dchoi98/iot-water-valve/images/external_view.jpg

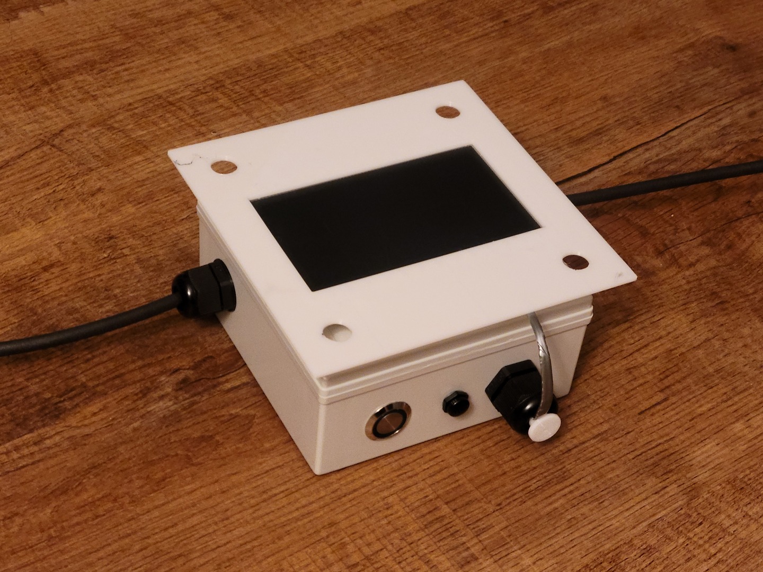
images/external_view.jpg
