dchoi98/iot-water-valve/images/internal_view.jpg

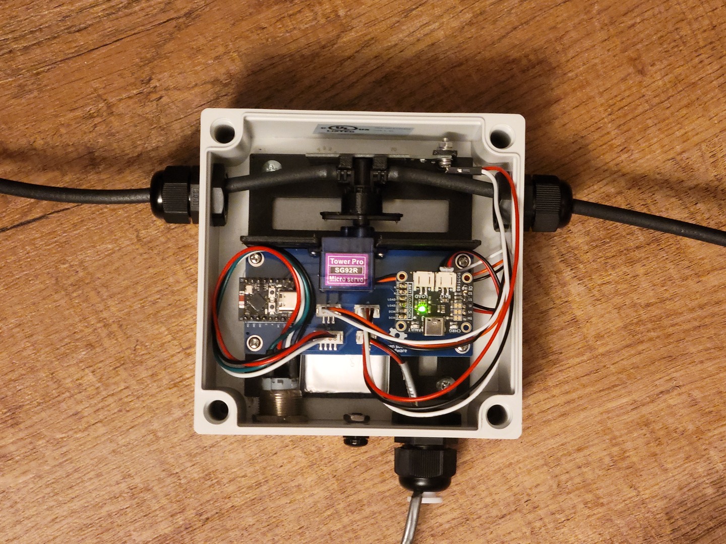
images/internal_view.jpg
