dchoi98/iot-water-valve/images/app_screenshot.png

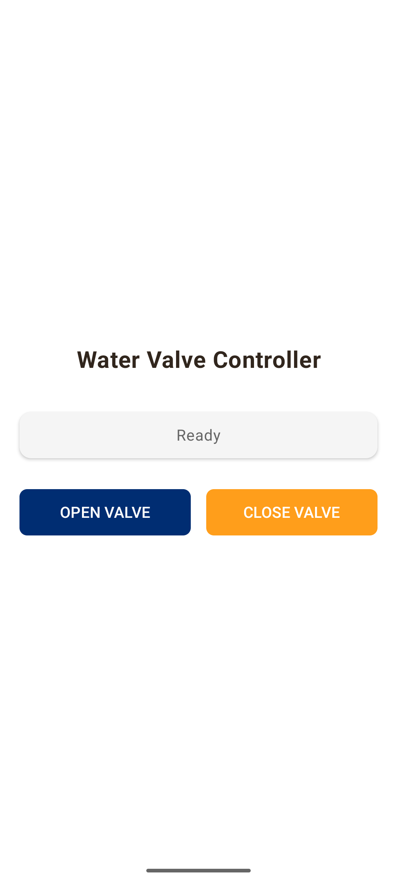
images/app_screenshot.png
