dchoi98/iot-water-valve/images/cad_exploded_view.jpg

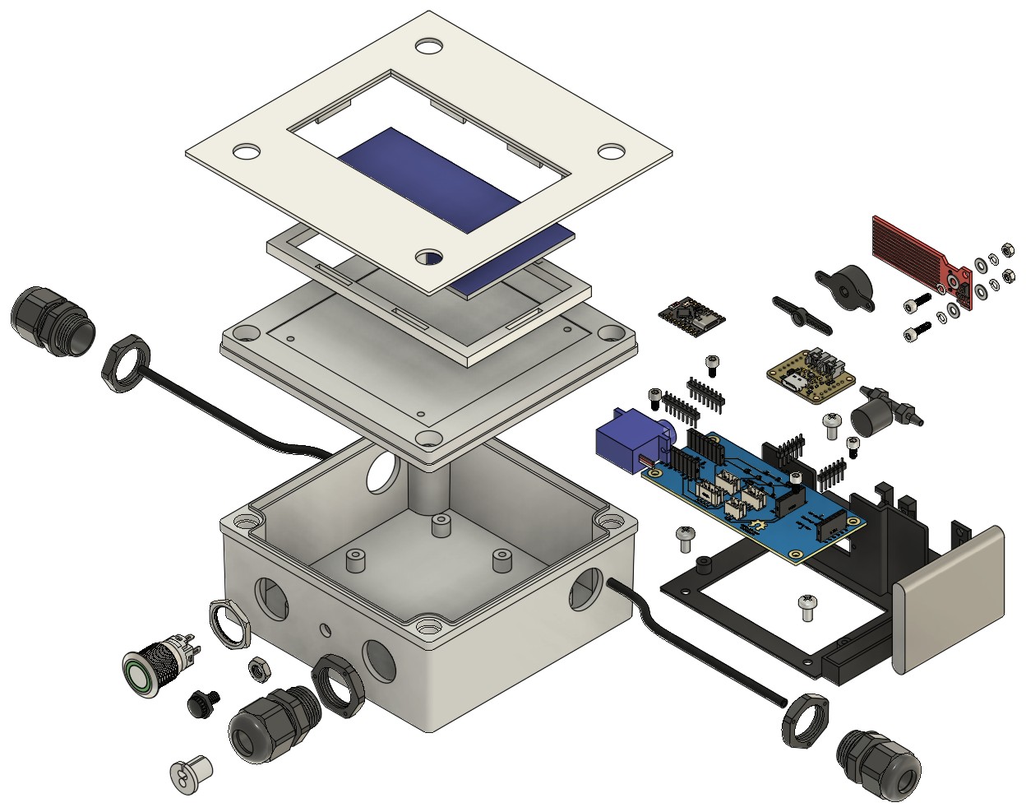
images/cad_exploded_view.jpg
