dchoi98/iot-water-valve/docs/pcb/pcb_bom.csv

Comment | Designator | Footprint | Supplier Part
4.7uF | C1 | C0402 | C23733
1N5819WS | D1,D2 | SOD-323_L1.8-W1.3-LS2.5-RD | C191023
22850108ANG1SYA01 | J1,J2 | HDR-TH_8P-P2.54-V-F-1 | C429957
DS1023-1x6SF11 | J3,J4 | HDR-TH_6P-P2.54-V-F | C7509518
B3B-PH-SM4-TB(LF)(SN) | J5,J6 | CONN-SMD_B3B-PH-SM4-TB-LF-SN | C160353
B4B-PH-SM4-TB(LF)(SN) | J7 | CONN-SMD_B4B-PH-SM4-TB-LF-SN | C160354
B2B-PH-SM4-TB(LF)(SN) | J8 | CONN-SMD_B2B-PH-SM4-TB-LF-SN | C160352
S8550 | Q1 | SOT-23-3_L2.9-W1.3-P1.90-LS2.4-BR | C20069126
2SC1815 | Q2 | SOT-23-3_L2.9-W1.3-P1.90-LS2.4-BR | C20069143
15kΩ | R1 | R0402 | C25756
150Ω | R2 | R0402 | C25082
1.5kΩ | R3 | R0402 | C25867
100kΩ | R4 | R0402 | C25741
HOLE_D3M_D6M5_PAD_PTH | S1,S2,S3,S4 | HOLE_D3M_D6M5_PAD_PTH
