dchoi98/iot-water-valve/docs/assembly_instructions/enclosure_drawing.pdf

29.3mm [1.15in] 30.2mm [1.19in] | 23.9mm [0.94in] 63.2mm [2.49in] | 30.2mm [1.19in] 30.5mm [1.20in]
25.0mm [0.98in] | 20.0mm [0.79in]

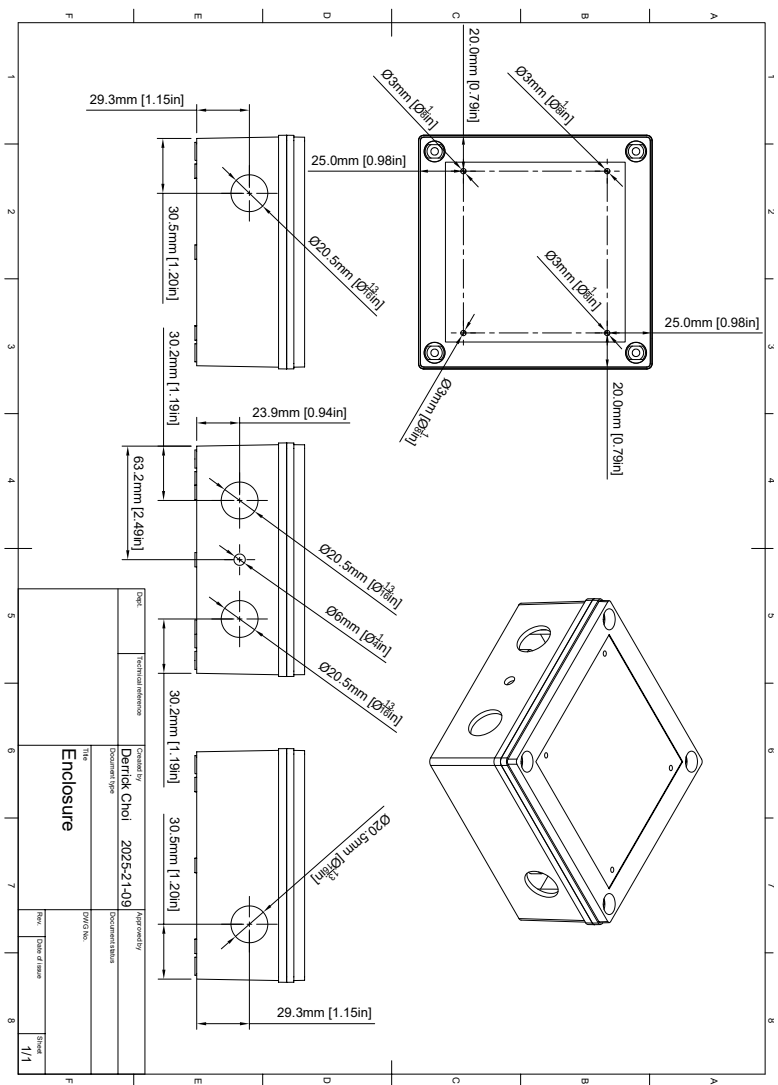
[picture p5: page 1]

1 A 2 3 4 5 6 7 8 1 2 3 4 5 6 7 8 FEDCB FEDCBA Dept. Technical reference Created by Approved by Title DWG No. Document type Document status Rev. Date of issue Sheet 2025-21-09 1/1 Enclosure Derrick Choi Ø20.5mm [Ø1316in] Ø6mm [Ø14in] Ø20.5mm [Ø1316in] Ø20.5mm [Ø1316in] Ø20.5mm [Ø1316in] 30.5mm [1.20in]
