dchoi98/iot-water-valve/(list of files, drawings)

Other design files:
hardware/pcb.epro
