dchoi98/iot-water-valve/docs/assembly_instructions/adafruit_io_configuration.md

# Adafruit IO Configuration

1. Go to https://io.adafruit.com and create an Adafruit IO account.
2. Click on the **Feeds** link in the header to navigate to the Feeds page.
3. Click on the New Feed button. A pop-up will appear with two text input fields.
4. Enter "valve-ack" into the Name field. You can put a long-form description of the feed in the Description field, but this is optional.
5. When you are done, click Create. You should now see the valve-ack feed on the Feeds page, under the Default group.
6. Repeat steps 3–5 for the valve-control and water-sensor feeds.
##
© 2025. This work is openly licensed via [CC BY-SA 4.0](https://creativecommons.org/licenses/by-sa/4.0/).
