dchoi98/iot-water-valve/esp32-firmware/esp32-firmware.ino

/*
    Copyright (C) 2025  Derrick Choi

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
    You should have received a copy of the GNU General Public License
    along with this program.  If not, see <http://www.gnu.org/licenses/>.
*/

#include "WiFi.h"
#include "WiFiClientSecure.h"
#include "ESP32Servo.h"
#include "esp_wifi.h"
#include "esp_pm.h"
#include "Adafruit_MQTT.h"
#include "Adafruit_MQTT_Client.h"
#include "ArduinoOTA.h"
#include "esp32_secrets.h"

// Adafruit IO credentials (TLS enabled)
#define AIO_SERVER "io.adafruit.com"
#define AIO_SERVERPORT 8883

// Hardware pin configuration
static constexpr uint8_t LED_PIN = 3;
static constexpr uint8_t WATER_SENSOR_PIN = 4;
static constexpr uint8_t SERVO_PIN = 5;
static constexpr uint8_t LATCH_INPUT_PIN = 6;
static constexpr uint8_t LATCH_OUTPUT_PIN = 7;

// Servo position constants
static constexpr uint8_t VALVE_CLOSE_ANGLE = 9;
static constexpr uint8_t VALVE_OPEN_ANGLE = 98;

// Sensor constants
static constexpr unsigned long SENSOR_READ_INTERVAL = 5000;
static constexpr int WATER_DETECTION_THRESHOLD = 700;

// Button timing
static constexpr unsigned long SHUTOFF_HOLD_TIME = 2000;

// Valve timing
static constexpr unsigned long VALVE_OPEN_INTERVAL = 1800000;

// MQTT ping timing
static constexpr unsigned long MQTT_PING_INTERVAL = 60000;

// Hardware objects
Servo water_valve_servo;

// State variables
static int water_sensor_reading = 0;
static unsigned long last_sensor_read_time = 0;
static unsigned long last_button_time = 0;
static unsigned long last_valve_open_time = 0;
static unsigned long last_ping_time = 0;
static bool button_pressed = false;
static bool valve_open = false;

// io.adafruit.com root CA certificate
static constexpr const char* ADAFRUIT_IO_ROOT_CA = \
      "-----BEGIN CERTIFICATE-----\n"
      "MIIEjTCCA3WgAwIBAgIQDQd4KhM/xvmlcpbhMf/ReTANBgkqhkiG9w0BAQsFADBh\n"
      "MQswCQYDVQQGEwJVUzEVMBMGA1UEChMMRGlnaUNlcnQgSW5jMRkwFwYDVQQLExB3\n"
      "d3cuZGlnaWNlcnQuY29tMSAwHgYDVQQDExdEaWdpQ2VydCBHbG9iYWwgUm9vdCBH\n"
      "MjAeFw0xNzExMDIxMjIzMzdaFw0yNzExMDIxMjIzMzdaMGAxCzAJBgNVBAYTAlVT\n"
      "MRUwEwYDVQQKEwxEaWdpQ2VydCBJbmMxGTAXBgNVBAsTEHd3dy5kaWdpY2VydC5j\n"
      "b20xHzAdBgNVBAMTFkdlb1RydXN0IFRMUyBSU0EgQ0EgRzEwggEiMA0GCSqGSIb3\n"
      "DQEBAQUAA4IBDwAwggEKAoIBAQC+F+jsvikKy/65LWEx/TMkCDIuWegh1Ngwvm4Q\n"
      "yISgP7oU5d79eoySG3vOhC3w/3jEMuipoH1fBtp7m0tTpsYbAhch4XA7rfuD6whU\n"
      "gajeErLVxoiWMPkC/DnUvbgi74BJmdBiuGHQSd7LwsuXpTEGG9fYXcbTVN5SATYq\n"
      "DfbexbYxTMwVJWoVb6lrBEgM3gBBqiiAiy800xu1Nq07JdCIQkBsNpFtZbIZhsDS\n"
      "fzlGWP4wEmBQ3O67c+ZXkFr2DcrXBEtHam80Gp2SNhou2U5U7UesDL/xgLK6/0d7\n"
      "6TnEVMSUVJkZ8VeZr+IUIlvoLrtjLbqugb0T3OYXW+CQU0kBAgMBAAGjggFAMIIB\n"
      "PDAdBgNVHQ4EFgQUlE/UXYvkpOKmgP792PkA76O+AlcwHwYDVR0jBBgwFoAUTiJU\n"
      "IBiV5uNu5g/6+rkS7QYXjzkwDgYDVR0PAQH/BAQDAgGGMB0GA1UdJQQWMBQGCCsG\n"
      "AQUFBwMBBggrBgEFBQcDAjASBgNVHRMBAf8ECDAGAQH/AgEAMDQGCCsGAQUFBwEB\n"
      "BCgwJjAkBggrBgEFBQcwAYYYaHR0cDovL29jc3AuZGlnaWNlcnQuY29tMEIGA1Ud\n"
      "HwQ7MDkwN6A1oDOGMWh0dHA6Ly9jcmwzLmRpZ2ljZXJ0LmNvbS9EaWdpQ2VydEds\n"
      "b2JhbFJvb3RHMi5jcmwwPQYDVR0gBDYwNDAyBgRVHSAAMCowKAYIKwYBBQUHAgEW\n"
      "HGh0dHBzOi8vd3d3LmRpZ2ljZXJ0LmNvbS9DUFMwDQYJKoZIhvcNAQELBQADggEB\n"
      "AIIcBDqC6cWpyGUSXAjjAcYwsK4iiGF7KweG97i1RJz1kwZhRoo6orU1JtBYnjzB\n"
      "c4+/sXmnHJk3mlPyL1xuIAt9sMeC7+vreRIF5wFBC0MCN5sbHwhNN1JzKbifNeP5\n"
      "ozpZdQFmkCo+neBiKR6HqIA+LMTMCMMuv2khGGuPHmtDze4GmEGZtYLyF8EQpa5Y\n"
      "jPuV6k2Cr/N3XxFpT3hRpt/3usU/Zb9wfKPtWpoznZ4/44c1p9rzFcZYrWkj3A+7\n"
      "TNBJE0GmP2fhXhP1D/XVfIW/h0yCJGEiV9Glm/uGOa3DXHlmbAcxSyCRraG+ZBkA\n"
      "7h4SeM6Y8l/7MBRpPCz6l8Y=\n"
      "-----END CERTIFICATE-----\n";

// MQTT setup with TLS
WiFiClientSecure secure_client;
Adafruit_MQTT_Client mqtt_client(&secure_client, AIO_SERVER, AIO_SERVERPORT, SECRET_AIO_USER, SECRET_AIO_KEY);
Adafruit_MQTT_Publish water_sensor_feed = Adafruit_MQTT_Publish(&mqtt_client, SECRET_AIO_USER "/feeds/water-sensor");
Adafruit_MQTT_Publish valve_ack_feed = Adafruit_MQTT_Publish(&mqtt_client, SECRET_AIO_USER "/feeds/valve-ack");
Adafruit_MQTT_Subscribe valve_control_feed = Adafruit_MQTT_Subscribe(&mqtt_client, SECRET_AIO_USER "/feeds/valve-control");

// Functions for hardware control
void move_servo_to_position(Servo& servo, uint8_t position, uint8_t pin)
{
    servo.attach(pin);
    servo.write(position);
    delay(500);
    servo.detach();

    const char* ack_message = (position == VALVE_OPEN_ANGLE) ? "opened" : "closed";
    valve_ack_feed.publish(ack_message);
}

void configure_power_management()
{
    esp_pm_config_t pm_config = {
            .max_freq_mhz = 80,
            .min_freq_mhz = 40,
            .light_sleep_enable = true
    };
    esp_pm_configure(&pm_config);
    esp_wifi_set_ps(WIFI_PS_MAX_MODEM);
    esp_wifi_set_max_tx_power(80);
}

void connect_to_wifi(const char* network_ssid, const char* network_password)
{
    if (WiFi.status() == WL_CONNECTED) {
        return;
    }

    pinMode(LED_BUILTIN, OUTPUT);
    pinMode(LED_PIN, OUTPUT);

    while (WiFi.status() != WL_CONNECTED) {
        WiFi.begin(network_ssid, network_password);

        for (uint8_t cycle = 0; cycle < 5; ++cycle) {
            check_button();
            digitalWrite(LED_BUILTIN, LOW);
            digitalWrite(LED_PIN, LOW);
            delay(200);
            digitalWrite(LED_BUILTIN, HIGH);
            digitalWrite(LED_PIN, HIGH);
            delay(200);
        }
    }

    ArduinoOTA.begin();

    digitalWrite(LED_BUILTIN, LOW);
    pinMode(LED_BUILTIN, INPUT);
}

// MQTT connection function
void connect_to_mqtt(Adafruit_MQTT_Client& mqtt_client_ref)
{
    if (mqtt_client_ref.connected()) {
        return;
    }

    int8_t connection_result;

    while ((connection_result = mqtt_client_ref.connect()) != 0) {
        check_button();
        connect_to_wifi(SECRET_WIFI_SSID, SECRET_WIFI_PASS);
        mqtt_client_ref.disconnect();
        delay(5000);
    }
}

void check_button()
{
    if (digitalRead(LATCH_INPUT_PIN) == LOW && !button_pressed) {
        button_pressed = true;
        last_button_time = millis();
    } else if (digitalRead(LATCH_INPUT_PIN) == HIGH) {
        button_pressed = false;
    }
    if (millis() - last_button_time > SHUTOFF_HOLD_TIME && button_pressed) {
        digitalWrite(LATCH_OUTPUT_PIN, LOW);
        digitalWrite(LED_PIN, LOW);
        esp_deep_sleep_start();
    }
}

// Sensor data publishing
void publish_sensor_data(Adafruit_MQTT_Publish& feed, int reading)
{
    const char* water_detected = (reading > WATER_DETECTION_THRESHOLD) ? "true" : "false";
    feed.publish(water_detected);
}

// Handle valve control commands
void handle_valve_command(const char* command, Servo& servo, uint8_t servo_pin)
{
    if (!command) return;
    size_t len = strnlen(command, 64);
    if (len == 0 || len >= 64) return;
    if (strcasecmp(command, "open") == 0) {
        move_servo_to_position(servo, VALVE_OPEN_ANGLE, servo_pin);
        last_valve_open_time = millis();
        valve_open = true;
    }
    else if (strcasecmp(command, "close") == 0) {
        move_servo_to_position(servo, VALVE_CLOSE_ANGLE, servo_pin);
        valve_open = false;
    }
}

void setup()
{
    pinMode(LATCH_OUTPUT_PIN, OUTPUT);
    digitalWrite(LATCH_OUTPUT_PIN, HIGH);

    pinMode(LATCH_INPUT_PIN, INPUT_PULLUP);

    configure_power_management();
    btStop();
    connect_to_wifi(SECRET_WIFI_SSID, SECRET_WIFI_PASS);

    secure_client.setCACert(ADAFRUIT_IO_ROOT_CA);

    // Subscribe to valve control feed
    mqtt_client.subscribe(&valve_control_feed);

    connect_to_mqtt(mqtt_client);

    publish_sensor_data(water_sensor_feed, water_sensor_reading);
}

void loop()
{
    ArduinoOTA.handle();

    check_button();

    // Maintain MQTT connection
    connect_to_mqtt(mqtt_client);

    // Process MQTT messages
    Adafruit_MQTT_Subscribe* subscription;
    while ((subscription = mqtt_client.readSubscription(100))) {
        if (subscription == &valve_control_feed) {
            handle_valve_command(
                    reinterpret_cast<char*>(valve_control_feed.lastread),
                    water_valve_servo,
                    SERVO_PIN
            );
        }
    }

    // Read and publish sensor data
    if (millis() - last_sensor_read_time > SENSOR_READ_INTERVAL) {
        water_sensor_reading = analogRead(WATER_SENSOR_PIN);

        // Auto-close valve if water detected
        if (water_sensor_reading > WATER_DETECTION_THRESHOLD) {
            move_servo_to_position(water_valve_servo, VALVE_CLOSE_ANGLE, SERVO_PIN);
            publish_sensor_data(water_sensor_feed, water_sensor_reading);
            delay(500);
            digitalWrite(LATCH_OUTPUT_PIN, LOW);
        }

        last_sensor_read_time = millis();
    }

    // Close valve if opened for 30 minutes
    if (millis() - last_valve_open_time > VALVE_OPEN_INTERVAL && valve_open) {
        move_servo_to_position(water_valve_servo, VALVE_CLOSE_ANGLE, SERVO_PIN);
        valve_open = false;
    }

    // Ping to keep connection alive
    if (millis() - last_ping_time > MQTT_PING_INTERVAL) {
        if (!mqtt_client.ping()) {
            mqtt_client.disconnect();
            move_servo_to_position(water_valve_servo, VALVE_CLOSE_ANGLE, SERVO_PIN);
        }
        
        last_ping_time = millis();
    }
}
