dchoi98/iot-water-valve/(commit log)

2025-06-30 Replace GET requests with POST requests
    [water_valve.ino]
2025-07-05 Modify to only publish water-sensor readings on startup and when water is detected
2025-07-07 Add connection to MQTT before initial publication to water-sensor feed
2025-07-08 Add LED and OFF pins, move Adafruit root CA to PROGMEM, change lambdas to void functions, convert use of String to static buffer
2025-07-10 Add confirmation of valve movement
2025-07-16 Add support for push-button power switch
2025-09-27 Move credentials to esp32_secrets.h and local.properties, add timer for valve, increase MQTT ping interval, reduced CPU clock, add support for OTA updates, change water sensor feed from sensor readin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
    [bom.csv, pcb.epro, pcb_bom.csv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]
2025-10-10 Reduce MQTT ping interval to 60 seconds, increase ESP32 WiFi Tx power to 20 dBm, add details to README.md, add images
